JimmyRoasts/LaMarzoccoTempSensor/20191230_163958.jpg

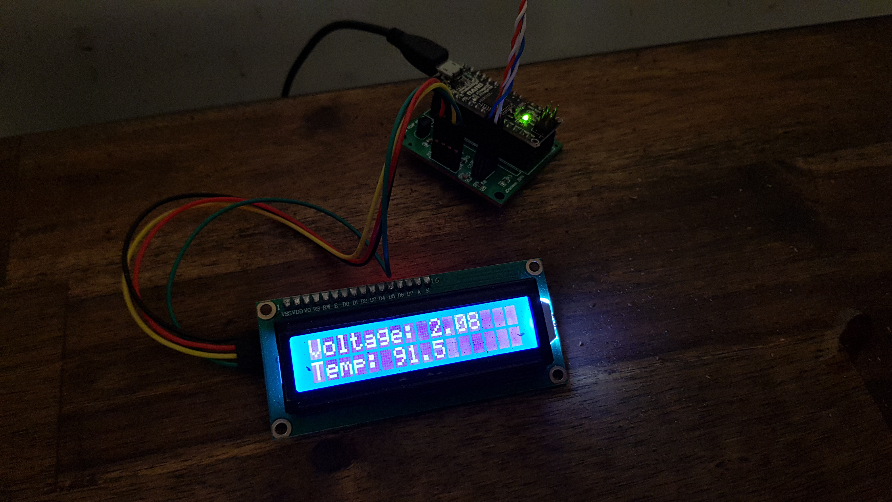
20191230_163958.jpg
