JimmyRoasts/LaMarzoccoTempSensor/20191230_164047.jpg

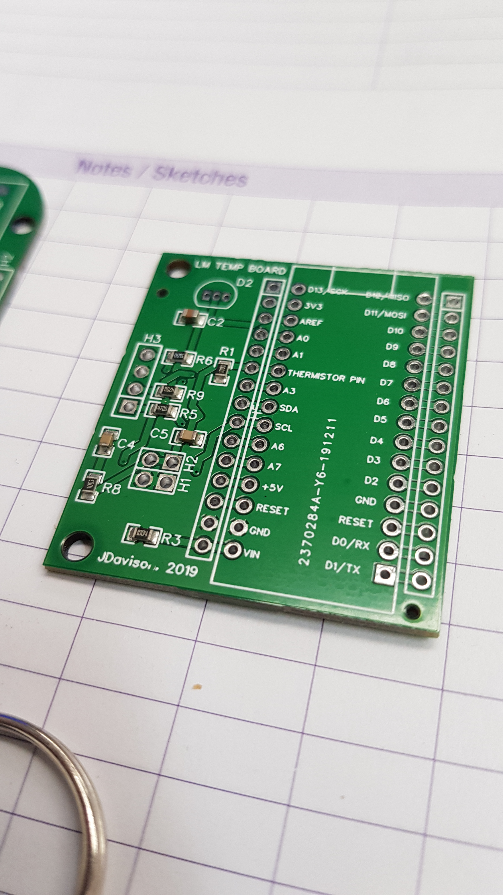
20191230_164047.jpg
