JimmyRoasts/LaMarzoccoTempSensor/Board Layout.pdf

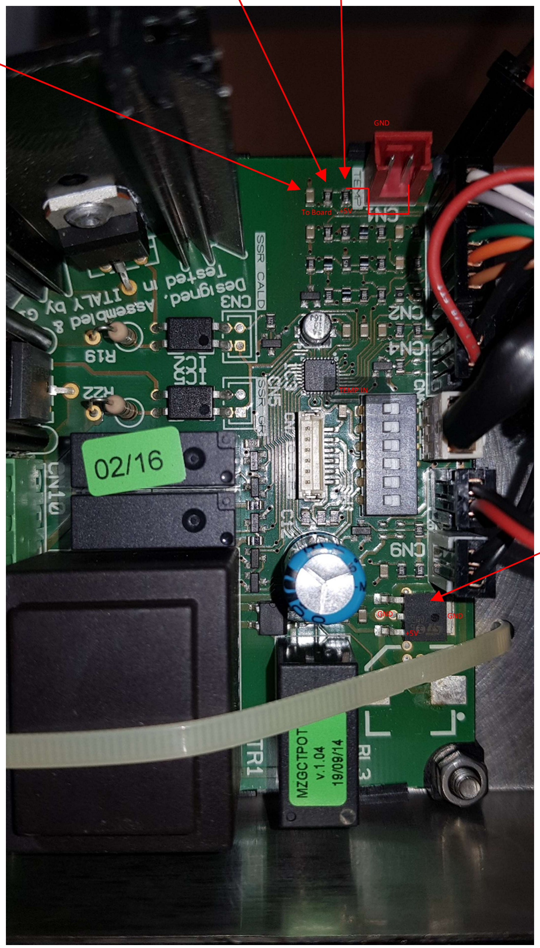
[picture p3: figure]
GND; To Board; TEMP IN

Decoupling Capacitor

(likely 100nF)

100kΩ Resistor tied to
adjacent cap

6.190kΩ Resistor

5v voltage regulator

78M05
