JimmyRoasts/LaMarzoccoTempSensor/20191230_163952.jpg

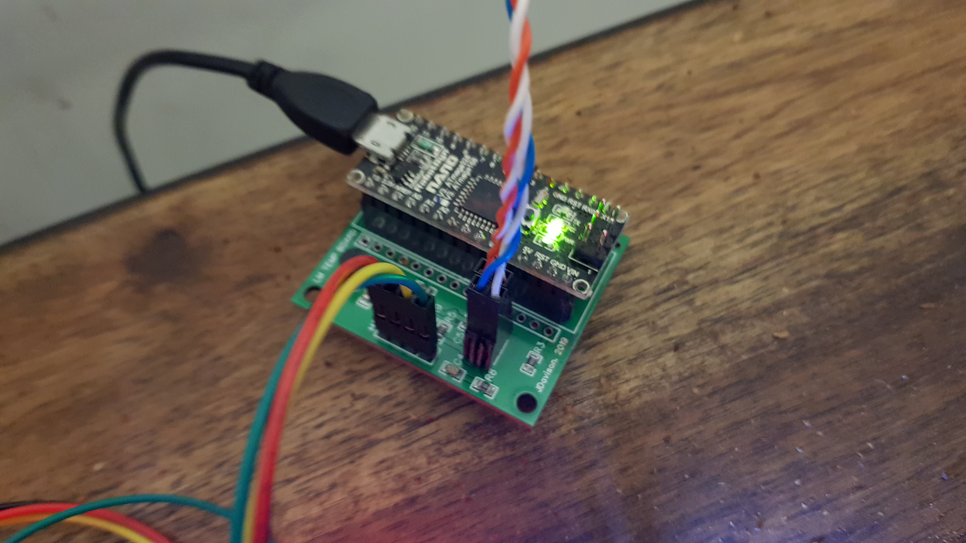
20191230_163952.jpg
