JimmyRoasts/LaMarzoccoTempSensor/20200129_161251.jpg

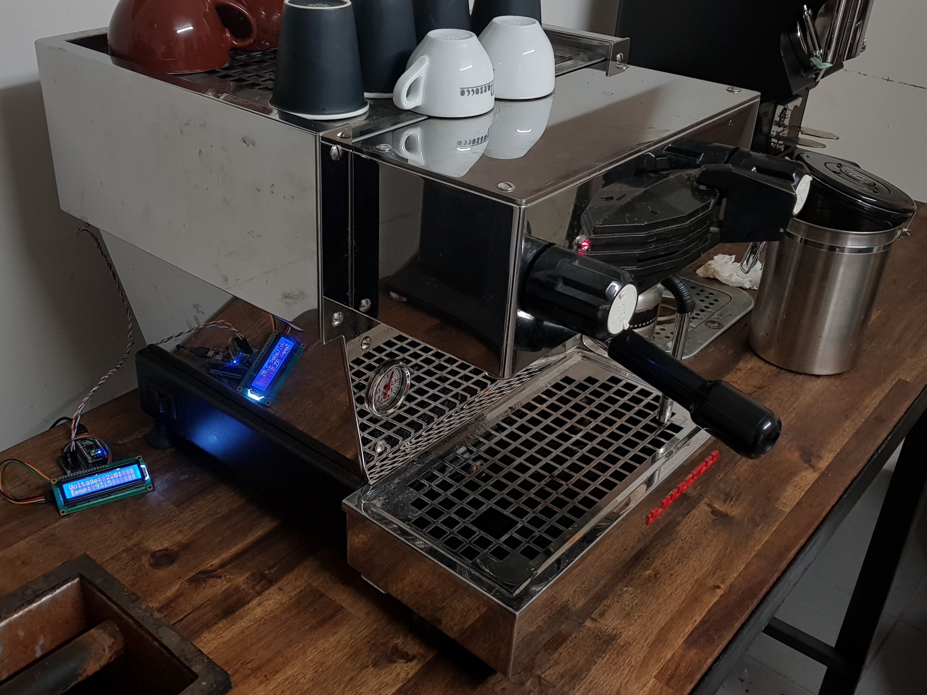
20200129_161251.jpg
