JimmyRoasts/LaMarzoccoTempSensor/LM Board Circuit.png

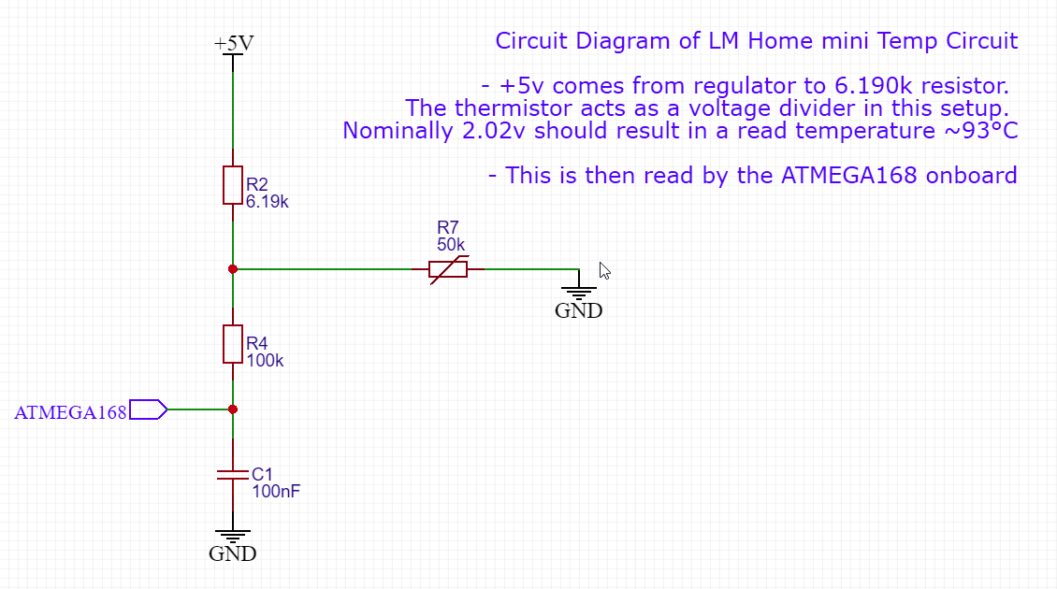
LM Board Circuit.png
