JimmyRoasts/LaMarzoccoTempSensor/(commit log)

2019-06-12 Create Steinhart Working.xlsx
    [Steinhart Working.xlsx]
2019-12-13 Updated Working Steinhart
    Updated sheet with data from LM
    [Steinhart Working.xlsx]
2020-01-22 Update to Readme
    I tested the boards from JLPCB in December 2019 and can confirm that they are working correctly. I removed the comment on the readme that indicated that hadn't been tested and replaced it with a **Tested and Working** comment instead.
2020-01-22 Addition of comment regarding delay in measurement loop
    User romankaelin asked whether delay in measurement loop was necessary. I'd seen this done in a few arduino sketches but on closer examination I don't think it is necessary here. Really the delay was serving the purpose of slowing the update rate of the LCD screen. I think a better way to implement this would be to have a timer that causes the LCD to report at a fixed rate. It's something to add in a future update.
    [LineaMiniThermistor.ino]
2020-01-29 Update to add non blocking timer
    This update is designed to remove the need for a blocking delay in the timer. The ReportDelay variable holds the minimum time (500ms) between lcd refreshes. When the current time minus the last reporting time exceeds this delay lcdReport is called. This function clears the lcd, and prints the last updated values for voltage and steinhart. Credit to user romankaelin for highlighting the limitations of using a blocking delay in the previous iteration of the code.
    [Steinhart Working.xlsx]
2020-01-29 Here are some photos of the build
    The attached photos show the board and the LCD.
